casartar/CameraSlider/Hardware/CameraSlider/A4988_STEPPER_MOTOR_DRIVER_CARRIER/A4988_STEPPER_MOTOR_DRIVER_CARRIER.step

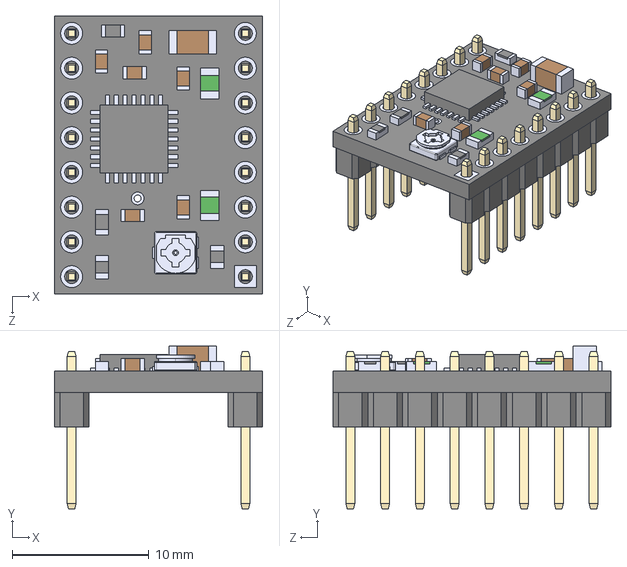
[picture p1: CAD file, 2021-06-19]
Hardware/CameraSlider/A4988_STEPPER_MOTOR_DRIVER_CARRIER/A4988_STEPPER_MOTOR_DRIVER_CARRIER.step
15.2 x 11.9 x 20.3 mm
