casartar/CameraSlider/Hardware/CameraSlider/CameraSlider.kicad_pcb

## KiCad design Hardware/CameraSlider/CameraSlider.kicad_pcb (2021-06-20)

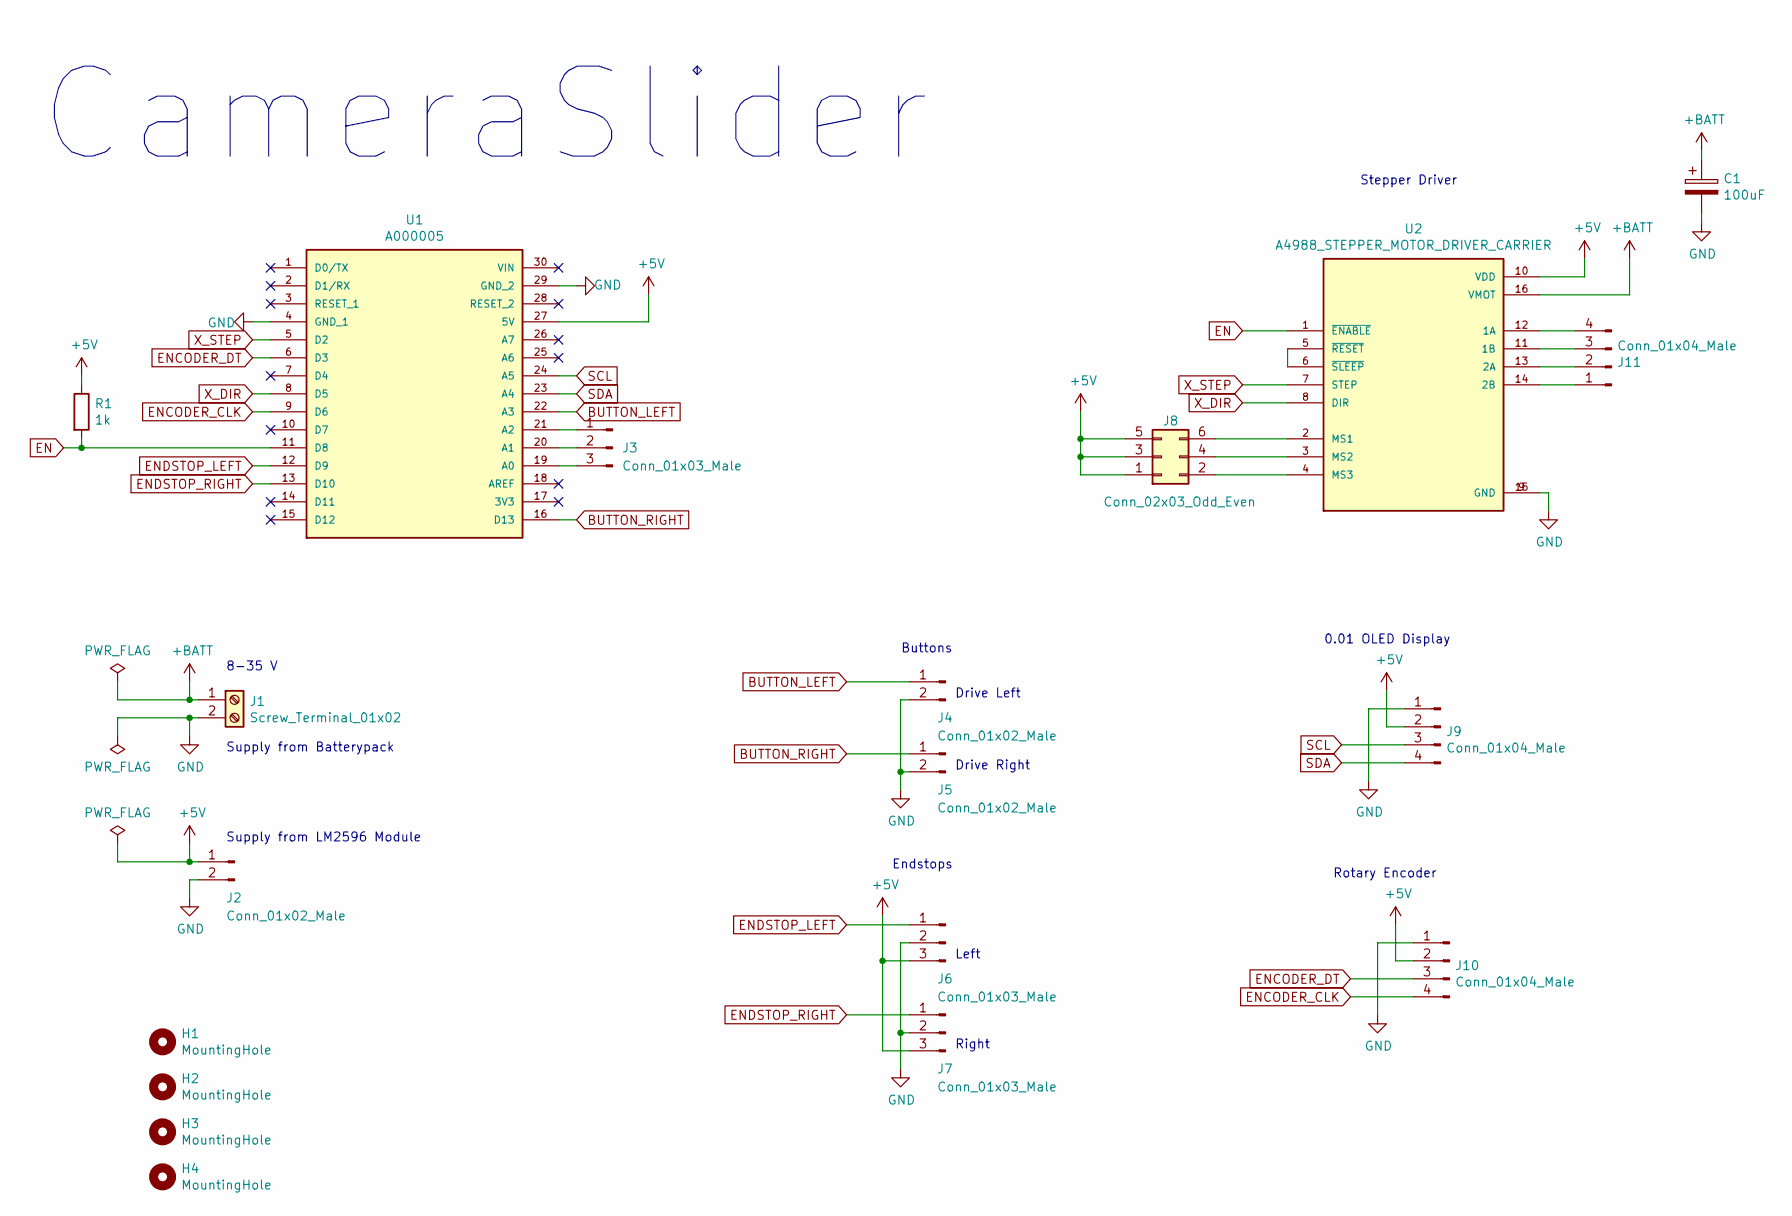
[picture p2: schematic CameraSlider.sch]

Parts:
C1: 100uF; CP_Radial_D8.0mm_P2.50mm
H1, H2, H3, H4: MountingHole; MountingHole_3.2mm_M3_Pad
J1: Screw_Terminal_01x02; TerminalBlock_Altech_AK300-2_P5.00mm
J2, J4, J5: Conn_01x02_Male; Pin_Header_Angled_1x02_Pitch2.54mm
J3: Conn_01x03_Male; Pin_Header_Straight_1x03_Pitch2.54mm
J6, J7: Conn_01x03_Male; Pin_Header_Angled_1x03_Pitch2.54mm
J8: Conn_02x03_Odd_Even; Pin_Header_Straight_2x03_Pitch2.54mm
J9, J10, J11: Conn_01x04_Male; Pin_Header_Angled_1x04_Pitch2.54mm
R1: 1k; R_Axial_DIN0207_L6.3mm_D2.5mm_P7.62mm_Horizontal
U1: A000005; MODULE_A000005; PARTREV 23/03/2020
U2: A4988_STEPPER_MOTOR_DRIVER_CARRIER; MODULE_A4988_STEPPER_MOTOR_DRIVER_CARRIER

Connections:
+5V: J2.1, J6.3, J7.3, J8.1, J8.3, J8.5, J9.2, J10.2, R1.1, U1.27 (5V), U2.10 (VDD)
+BATT: C1.1, J1.1, U2.16 (VMOT)
BUTTON_LEFT: J4.1, U1.22 (A3)
BUTTON_RIGHT: J5.1, U1.16 (D13)
EN: R1.2, U1.11 (D8), U2.1 (~ENABLE)
ENCODER_CLK: J10.4, U1.9 (D6)
ENCODER_DT: J10.3, U1.6 (D3)
ENDSTOP_LEFT: J6.1, U1.12 (D9)
ENDSTOP_RIGHT: J7.1, U1.13 (D10)
GND: C1.2, J1.2, J2.2, J4.2, J5.2, J6.2, J7.2, J9.1, J10.1, U1.4 (GND_1), U1.29 (GND_2), U2.9 (GND), U2.15 (GND)
unnamed: J3.1, U1.21 (A2)
unnamed: J3.2, U1.20 (A1)
unnamed: J3.3, U1.19 (A0)
unnamed: J8.2, U2.4 (MS3)
unnamed: J8.4, U2.3 (MS2)
unnamed: J8.6, U2.2 (MS1)
unnamed: J11.1, U2.14 (2B)
unnamed: J11.2, U2.13 (2A)
unnamed: J11.3, U2.11 (1B)
unnamed: J11.4, U2.12 (1A)
unnamed: U2.5 (~RESET), U2.6 (~SLEEP)
SCL: J9.3, U1.24 (A5)
SDA: J9.4, U1.23 (A4)
X_DIR: U1.8 (D5), U2.8 (DIR)
X_STEP: U1.5 (D2), U2.7 (STEP)

Notes on the sheet:
0.01 OLED Display
Stepper Driver
Rotary Encoder
Buttons
Endstops
Drive Left
Drive Right
Left
Right
CameraSlider
8-35 V
Supply from Batterypack
Supply from LM2596 Module

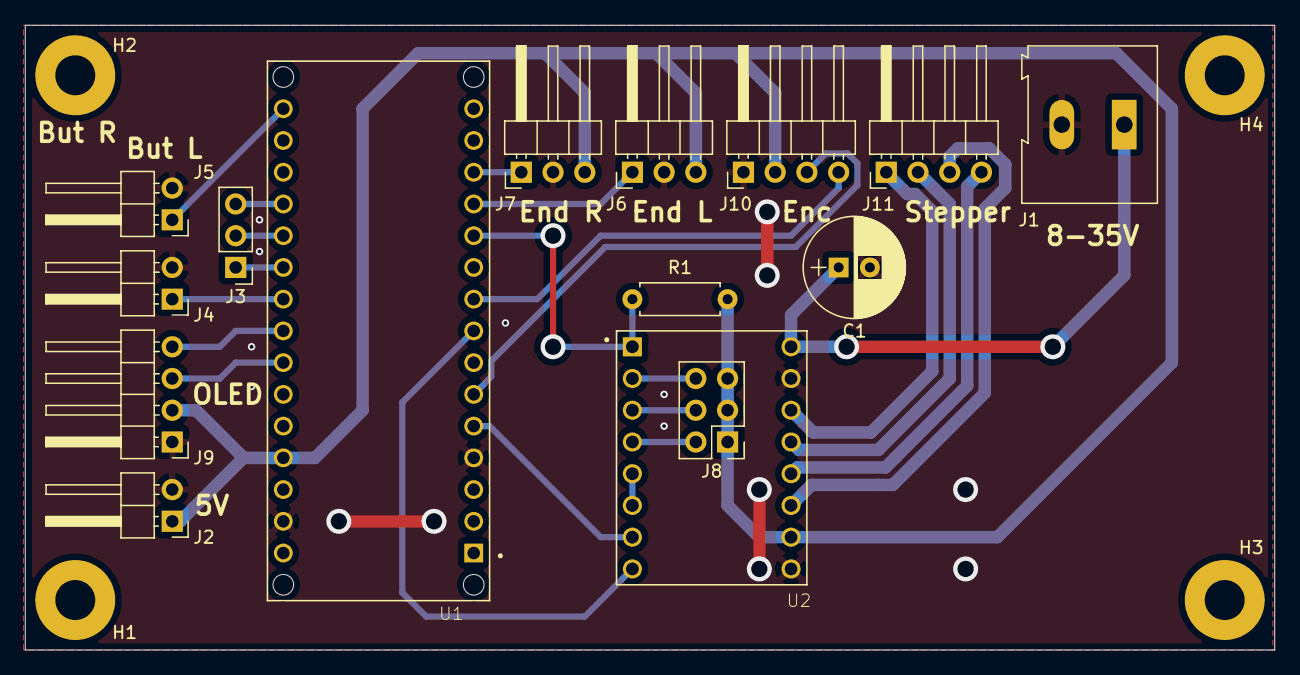
[picture p3: board CameraSlider.kicad_pcb from above]

Board: 2 copper layers, 100.0 x 50.0 mm, 19 parts (0 on the bottom side), 25 nets.
