casartar/CameraSlider/(commit log)

2021-06-19 Hardware PCB Schematic hinzugefügt
    [A4988_STEPPER_MOTOR_DRIVER_CARRIER.step, CameraSlider.kicad_pcb, CameraSlider.sch]
2021-06-20 Layout hinzugefügt
    [CameraSlider.kicad_pcb, CameraSlider.sch]
2021-06-20 Clearence vergrößert und GND Drahtbrücke hinzugefügt
    [CameraSlider.kicad_pcb]
2021-06-26 Stepper enable invertiert
2022-05-29 add Gerbers
    [CameraSlider-B_Cu.gbl, CameraSlider-B_Mask.gbs, CameraSlider-B_SilkS.gbo, CameraSlider-Edge_Cuts.gm1, CameraSlider-F_Cu.gtl, CameraSlider-F_Mask.gts, CameraSlider-F_SilkS.gto, CameraSlider-job.gbrjob]
